Gash13/control-pelota-pid/Informe/Informe/imagenes/vlcsnap-2025-06-24-01h48m53s366.png

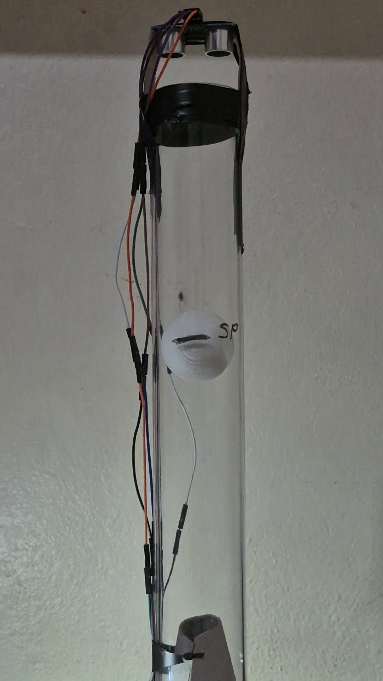
Informe/Informe/imagenes/vlcsnap-2025-06-24-01h48m53s366.png
